mp-woodman/RallyApp/0090_E-Paper_Display/00_Code/00_E_Paper_2_9_Example_VS_Code/MonitorOutput.md

Testprogramm Epaper
[E][esp32-hal-cpu.c:125] removeApbChangeCallback(): not found func=400D660C arg=3FFB1394
