mp-woodman/RallyApp/0120_Hardware/00_ESP_Shield/Partlist.xlsx

Kundenreferenz | Beschreibung | Hersteller-Teilenummer | Hersteller | Distributor | Distributor Teilenummer | Menge | Stückpreis | Gesamtpreis
B1 | BUZZER, 12 MM X 9.5 MM DEEP, M, | CMI-1295IC-0385T | CUI Devices | DigiKey | 2223-CMI-1295IC-0385T-ND | 1 | 1.04 € | 1.04 €
C1,C2 | CAP CER 22PF 50V C0G/NP0 0805 | C0805C220J5GACTU | KEMET | DigiKey | 399-1113-1-ND | 2 | 0.08 € | 0.16 €
C11,C14,C16,C17,C18,C20,C24,C23 | CAP CER 0.1UF 50V X7R 0805 | C0805C104J5RAC7025 | KEMET | DigiKey | 399-C0805C104J5RAC7025CT-ND | 8 | 0.11 € | 0.91 €
C12,C13 | CAP CER 33PF 50V X7R 0805 | 08055C330KAT2A | AVX Corporation | DigiKey | 478-12787-1-ND | 2 | 0.19 € | 0.38 €
C15 | CAP CER 1000PF 50V X7R 0805 | C0805C102K5RAC7210 | KEMET | DigiKey | 399-C0805C102K5RAC7210CT-ND | 1 | 0.10 € | 0.10 €
C19,C22,C25,C21 | CAP CER 10UF 10V X7R 0805 | C0805C106K8RACTU | KEMET | DigiKey | 399-7411-1-ND | 4 | 0.33 € | 1.32 €
C26,C27 | CAP CER 4.7UF 25V X7R 0805 | C0805C475K3RAC7800 | KEMET | DigiKey | 399-C0805C475K3RAC7800CT-ND | 2 | 0.49 € | 0.98 €
C28 | CAP CER 0805 2.2UF 16V X7R 5% | C0805C225J4REC7800 | KEMET | DigiKey | 399-C0805C225J4REC7800CT-ND | 1 | 0.25 € | 0.25 €
C29 | CAP TANT 47UF 20% 10V 0805 | TCSP1A476M8R | Rohm Semiconductor | DigiKey | 511-TCSP1A476M8RCT-ND | 1 | 0.85 € | 0.85 €
C3,C4 | CAP CER 220PF 50V X7R 0805 | C0805C221M5RACTU | KEMET | DigiKey | 399-8039-1-ND | 2 | 0.08 € | 0.16 €
C7,C8 | CAP CER 100PF 50V X7R 0805 | C0805C101J5RAC7800 | KEMET | DigiKey | 399-17420-1-ND | 2 | 0.13 € | 0.26 €
IC1 | IC REG LINEAR 3.3V 1A 8SO | AP7361C-33SP-13 | Diodes Incorporated | DigiKey | AP7361C-33SP-13DICT-ND | 1 | 0.55 € | 0.55 €
IC2 | IC BATT CHG LI-ION 1CELL 6MLP | SC810ULTRT | Semtech Corporation | DigiKey | SC810ULCT-ND | 1 | 1.49 € | 1.49 €
IC3 | IC COMP WINDOW W/REF 6SOT | TPS3700DDCR | Texas Instruments | DigiKey | 296-30395-1-ND | 1 | 1.56 € | 1.56 €
L1, L2 | FERRITE BEAD 100 OHM 0805 1LN | MPZ2012S101AT000 | TDK Corporation | DigiKey | 445-1567-1-ND | 1 | 0.09 € | 0.09 €
L3,L4 | FIXED IND 560NH 450MA 1.1 OHM | 744760256A | Würth Elektronik | DigiKey | 732-3438-1-ND | 2 | 0.36 € | 0.72 €
L3,L4 alternative | FIXED IND 560NH 230MA 1.9 OHM | LQW2BASR56J00L | Murata Electronics | DigiKey | 490-5675-1-ND | 2 | 0.19 € | 0.38 €
L3,L4 alternative | FIXED IND 560NH 150MA 550 MOHM | MLF2012DR56KT000 | TDK Corporation | DigiKey | 445-1044-1-ND | 2 | 0.15 € | 0.30 €
LED1 | LED GREEN CLEAR SMD | LTST-C170KGKT | Lite-On Inc. | DigiKey | 160-1414-1-ND | 1 | 0.29 € | 0.29 €
LED2 | LED RED CLEAR SMD | LTST-C170EKT | Lite-On Inc. | DigiKey | 160-1178-1-ND | 1 | 0.27 € | 0.27 €
PCB | 140mmx85mm two layer PCB | 2.9inch e-Paper Module | JLC PCB | JLCPCB |  | 1 | 3.00 € | 3.00 €
R1 | RES SMD 1K OHM 0.5% 1/5W 0805 | MCU0805MD1001DP500 | Vishay Beyschlag/Draloric/BC Components | DigiKey | MCU0805-1.00K-MDCT-ND | 1 | 0.32 € | 0.32 €
R11 | RES 590K OHM 0.1% 1/8W 0805 | ERA-6AEB5903V | Panasonic Electronic Components | DigiKey | P590KDACT-ND | 1 | 0.26 € | 0.26 €
R12 | RES 47K OHM 0.1% 1/8W 0805 | ERA-6AEB473V | Panasonic Electronic Components | DigiKey | P47KDACT-ND | 1 | 0.26 € | 0.26 €
R13 | RES SMD 64.9K OHM 0.1% 1/4W 0805 | ERJ-PB6B6492V | Panasonic Electronic Components | DigiKey | P20801CT-ND | 1 | 0.27 € | 0.27 €
R14 | RES 50K OHM 0.1% 1/5W 0805 | PTN0805E5002BST1 | Vishay Thin Film | DigiKey | 764-1535-1-ND | 1 | 0.55 € | 0.55 €
R15,R16 | RES SMD 5.1K OHM 1% 0.4W 0805 | RCS08055K10FKEA | Vishay Dale | DigiKey | 541-RCS08055K10FKEACT-ND | 2 | 0.21 € | 0.42 €
R2 | RES 1.69K OHM 0.1% 1/5W 0805 | TNPW08051K69BEEA | Vishay Dale | DigiKey | 541-4562-1-ND | 1 | 0.61 € | 0.61 €
R3,R4 | RES SMD 1.5 OHM 1% 0.4W 0805 | RCS08051R50FKEA | Vishay Dale | DigiKey | 541-10511-1-ND | 2 | 0.21 € | 0.42 €
R7 | RES SMD 10K OHM 0.1% 1/8W 0805 | MCU08050D1002BP500 | Vishay Beyschlag/Draloric/BC Components | DigiKey | MCU0805-10K-DBCT-ND | 1 | 0.48 € | 0.48 €
R8, R10 | RES 130 OHM 0.5% 1/8W 0805 | ERA-6AED131V | Panasonic Electronic Components | DigiKey | P123804CT-ND | 1 | 0.08 € | 0.08 €
R8,R10 alternative | RES SMD 1.3K OHM 1% 0.4W 0805 | RCS08051K30FKEA | Vishay Dale | DigiKey | 541-RCS08051K30FKEACT-ND | 2 | 0.21 € | 0.42 €
R8,R10 alternative | RES SMD 13K OHM 1% 0.4W 0805 | RCS080513K0FKEA | Vishay Dale | DigiKey | 541-RCS080513K0FKEACT-ND | 2 | 0.21 € | 0.42 €
R9 | RES 2.05K OHM 0.1% 1/5W 0805 | TNPW08052K05BEEN | Vishay Dale | DigiKey | 541-1896-1-ND | 1 | 0.72 € | 0.72 €
S1 | SWITCH PUSHBUTTON SPST 1A 30V | GPTS203211B | CW Industries | DigiKey | CW181-ND | 1 | 1.39 € | 1.39 €
U1 | IC RFID RDR/TRAN 13.56MZ 40HVQFN | PN5321A3HN/C106;55 | NXP USA Inc. | DigiKey | 568-8600-ND | 1 | 10.33 € | 10.33 €
U3 alternative | ESP32-WROOM-32E 4MB FLASH | ESP32-DEVKITC-32E | Espressif Systems | DigiKey | 1965-ESP32-DEVKITC-32E-ND | 1 | 8.24 € | 8.24 €
U3 | ESP32-WROOM-32UE 4MB FLASH | ESP32-DEVKITC-32UE | Espressif Systems | DigiKey | 1965-ESP32-DEVKITC-32UE-ND | 1 | 8.24 € | 8.24 €
X1 | CONN RCPT USB2.0 TYPEC 16POS | USB4085-GF-A | GCT | DigiKey | 2073-USB4085-GF-ACT-ND | 1 | 1.10 € | 1.10 €
X3 | CONN HEADER SMD R/A 8POS 2MM | S8B-PH-SM4-TB(LF)(SN) | JST Sales America Inc. | DigiKey | 455-1755-1-ND | 1 | 0.72 € | 0.72 €
X3.1 | CONN HOUSING PH 8POS 2MM WHITE | PHR-8 | JST Sales America Inc. | DigiKey | 455-1189-ND | 1 | 0.13 € | 0.13 €
X3.1 | CONN SOCKET 24-28AWG CRIMP TIN | SPH-002T-P0.5L | JST Sales America Inc. | DigiKey | 455-2148-1-ND | 5 | 0.08 € | 0.40 €
Y1 | CRYSTAL 27.1200MHZ 18PF SMD | 7M-27.120MAAJ-T | TXC CORPORATION | DigiKey | 887-1424-1-ND | 1 | 0.75 € | 0.75 €
 | Lithium Ion Mangan Akku GDIHR18650PC |  | FREI | Reichelt | LIMG GDIHR18650Z | 1 | 7.17 € | 7.17 €
 | Display ePaper, 2,9", schwarz/weiß | li ion 18650 | Waveshare | Reichelt | DEBO EPA 2.9 | 1 | 21.60 € | 21.60 €
 |  |  |  |  |  |  |  | 80.36 €
