mp-woodman/RallyApp/0120_Hardware/00_ESP_Shield/RallyESP_Shield/RallyESP_Shield_V1.brd

## EAGLE design 0120_Hardware/00_ESP_Shield/RallyESP_Shield/RallyESP_Shield_V1.brd (2021-02-15)

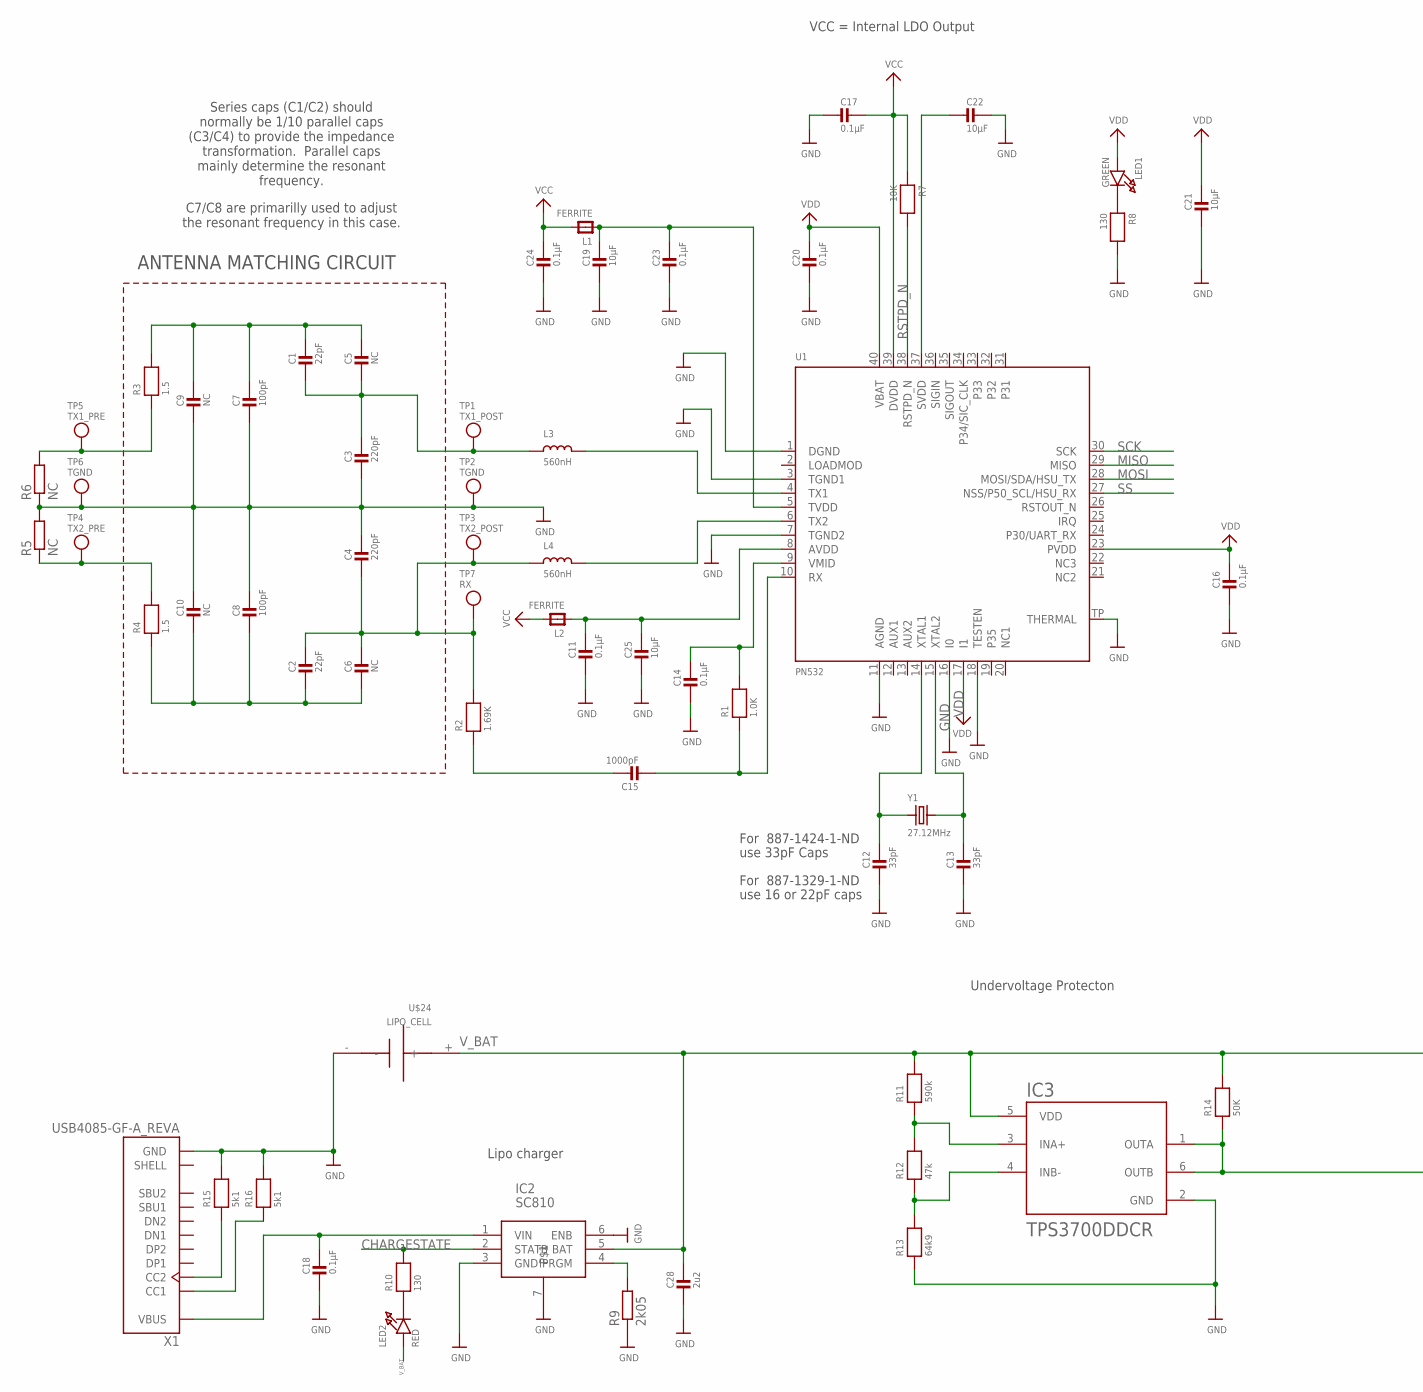
[picture p66: schematic RallyESP_Shield_V1.sch, part in row 1, column 1]

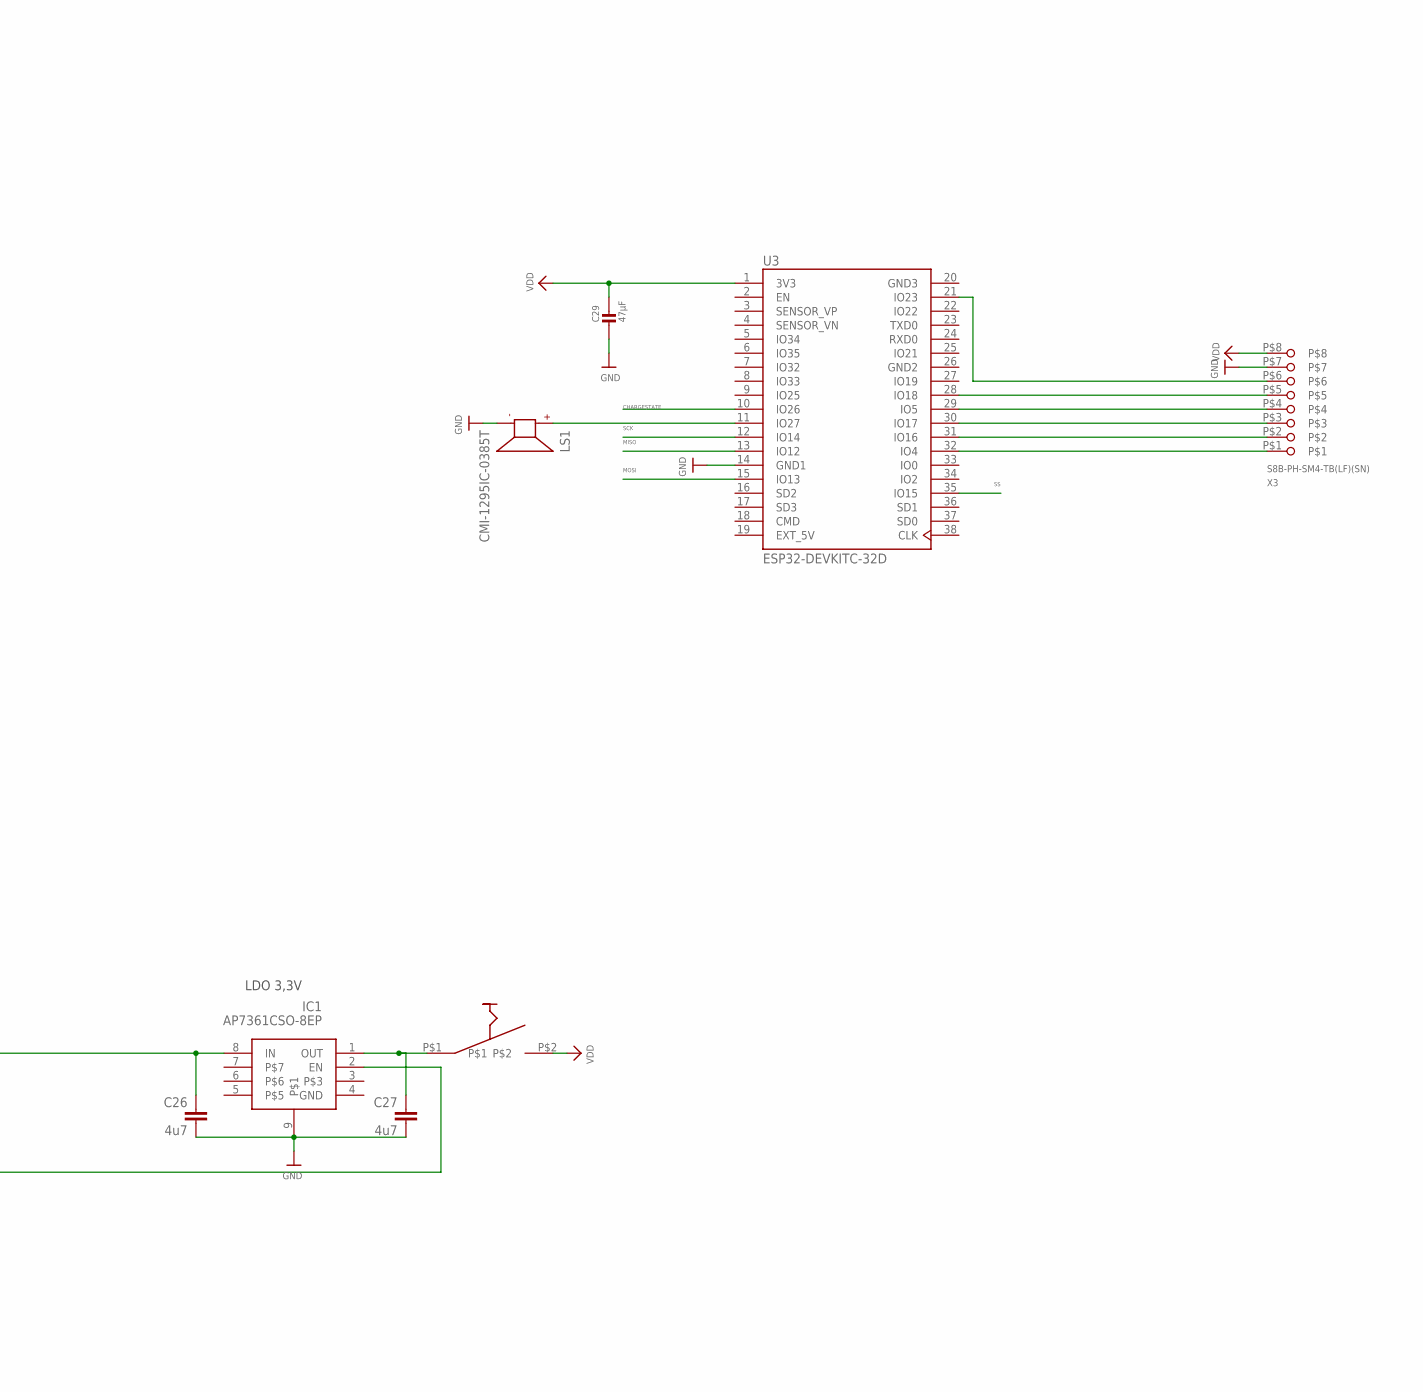
[picture p67: schematic RallyESP_Shield_V1.sch, part in row 1, column 2]

Parts:
C1, C2: 22pF; 0805-NO
C3, C4: 220pF; 0805-NO
C5, C6, C9, C10: NC; 0805-NO
C7, C8: 100pF; 0805-NO
C11, C14, C16, C17, C18, C20, C23, C24: 0.1µF; 0805-NO
C12, C13: 33pF; 0805-NO
C15: 1000pF; 0805-NO
C19, C21, C22, C25: 10µF; 0805-NO
C26, C27: 4u7; C0805
C28: 2u2; 0805-NO
C29: 47µF; 0805-NO
IC1: AP7361CSO-8EP; SOIC127P595X150-9T240X300N
IC2: SC810; MLPD-UT6
IC3: TPS3700DDCR; SOT95P280X110-6N
L1, L2: FERRITE; 0805
L3, L4: 560nH; 0805
LED1: GREEN; CHIPLED_0805_NOOUTLINE
LED2: RED; CHIPLED_0805_NOOUTLINE
LS1: CMI-1295IC-0385T; CUI_CMI-1295IC-0385T
R1: 1.0K; 0805-NO
R2: 1.69K; 0805-NO
R3, R4: 1.5; 0805-NO
R5, R6: NC; R0201
R7: 10K; 0805-NO
R8, R10: 130; 0805-NO
R9: 2k05; R0805
R11: 590k; 0805-NO
R12: 47k; 0805-NO
R13: 64k9; 0805-NO
R14: 50K; 0805-NO
R15, R16: 5k1; 0805-NO
TP1: TX1_POST; TESTPOINT_ROUND_1MM
TP2, TP6: TGND; TESTPOINT_ROUND_1MM
TP3: TX2_POST; TESTPOINT_ROUND_1MM
TP4: TX2_PRE; TESTPOINT_ROUND_1MM
TP5: TX1_PRE; TESTPOINT_ROUND_1MM
TP7: RX; TESTPOINT_ROUND_1MM
U1: PN532; HVQFN40-6X6
U3: ESP32-DEVKITC-32D; MODULE_ESP32-DEVKITC-32D
U$24: LIPO_CELL; LIPO_18X65
U$46: GPTS203211B
X1: USB4085-GF-A_REVA; GCT_USB4085-GF-A_REVA
X3: S8B-PH-SM4-TB(LF)(SN); 8_PIN_SMD_2MM
Y1: 27.12MHz; CRYSTAL_3.2X2.5

Connections:
CHARGESTATE: IC2.2 (STATB), R10.2, U3.10 (IO26)
EXT_5V: U3.19 (EXT_5V)
GND: C3.2, C4.1, C7.2, C8.1, C9.2, C10.1, C11.2, C12.2, C13.2, C14.2, C16.2, C17.2, C18.2, C19.2, C20.2, C21.2, C22.1, C23.2, C24.2, C25.2, C26.2, C27.2, C28.2, C29.2, IC1.9, IC2.3 (GND), IC2.6 (ENB), IC2.7, IC3.2 (GND), LS1.N, R5.2, R6.1, R8.2, R9.1, R13.1, R15.2, R16.2, TP2.P$1, TP6.P$1, U1.1 (DGND), U1.3 (TGND1), U1.7 (TGND2), U1.11 (AGND), U1.16 (I0), U1.18 (TESTEN), U1.TP (THERMAL), U3.14 (GND1), U$24.-, X1.A1 (GND), X1.A12 (GND), X1.B1 (GND), X1.B12 (GND), X3.P$7
GND2: U3.26 (GND2)
GND3: U3.20 (GND3)
MISO: U1.29 (MISO), U3.13 (IO12)
MOSI: U1.28 (MOSI/SDA/HSU_TX), U3.15 (IO13)
unnamed: L3.2, U1.4 (TX1)
unnamed: L4.2, U1.6 (TX2)
unnamed: C1.2, C3.1, C5.2, L3.1, TP1.P$1
unnamed: R3.1, R6.2, TP5.P$1
unnamed: R4.2, R5.1, TP4.P$1
unnamed: LED1.C, R8.1
unnamed: C12.1, U1.14 (XTAL1), Y1.1
unnamed: C13.1, U1.15 (XTAL2), Y1.2
unnamed: C15.1, R2.1
unnamed: C14.1, R1.2, U1.9 (VMID)
unnamed: C15.2, R1.1, U1.10 (RX)
unnamed: C2.1, C4.2, C6.1, L4.1, R2.2, TP3.P$1, TP7.P$1
unnamed: C11.1, C25.1, L2.1, U1.8 (AVDD)
unnamed: C19.1, C23.1, L1.1, U1.5 (TVDD)
unnamed: C22.2, U1.37 (SVDD)
unnamed: LS1.P, U3.11 (IO27)
unnamed: IC3.3 (INA+), R11.1, R12.2
unnamed: IC3.4 (INB-), R12.1, R13.2
unnamed: IC1.2 (EN), IC3.1 (OUTA), IC3.6 (OUTB), R14.1
unnamed: C27.1, IC1.1 (OUT), U$46.P$1
unnamed: R15.1, X1.B5 (CC2)
unnamed: R16.1, X1.A5 (CC1)
unnamed: U3.32 (IO4), X3.P$1
unnamed: U3.31 (IO16), X3.P$2
unnamed: U3.30 (IO17), X3.P$3
unnamed: U3.29 (IO5), X3.P$4
unnamed: U3.28 (IO18), X3.P$5
unnamed: U3.21 (IO23), X3.P$6
unnamed: IC2.4 (IPRGM), R9.2
unnamed: LED2.C, R10.1
unnamed: C18.1, IC2.1 (VIN), X1.A4 (VBUS), X1.A9 (VBUS), X1.B4 (VBUS), X1.B9 (VBUS)
RSTPD_N: R7.2, U1.38 (RSTPD_N)
SCK: U1.30 (SCK), U3.12 (IO14)
SS: U1.27 (NSS/P50_SCL/HSU_RX), U3.35 (IO15)
TX1_ANTENNA: C1.1, C5.1, C7.1, C9.1, R3.2
TX2_ANTENNA: C2.2, C6.2, C8.2, C10.2, R4.1
VCC: C17.1, C24.1, L1.2, L2.2, R7.1, U1.39 (DVDD)
VDD: C16.1, C20.1, C21.1, C29.1, LED1.A, U1.17 (I1), U1.23 (PVDD), U1.40 (VBAT), U3.1 (3V3), U$46.P$2, X3.P$8
V_BAT: C26.1, C28.1, IC1.8 (IN), IC2.5 (BAT), IC3.5 (VDD), LED2.A, R11.2, R14.2, U$24.+

Notes on the sheet:
ANTENNA MATCHING CIRCUIT
For 887-1329-1-ND
use 16 or 22pF caps
For 887-1424-1-ND
use 33pF Caps
VCC = Internal LDO Output
Series caps (C1/C2) should normally be 1/10 parallel caps (C3/C4) to provide the impedance transformation. Parallel caps mainly determine the resonant frequency.
C7/C8 are primarilly used to adjust the resonant frequency in this case.
Undervoltage Protecton
Lipo charger
LDO 3,3V

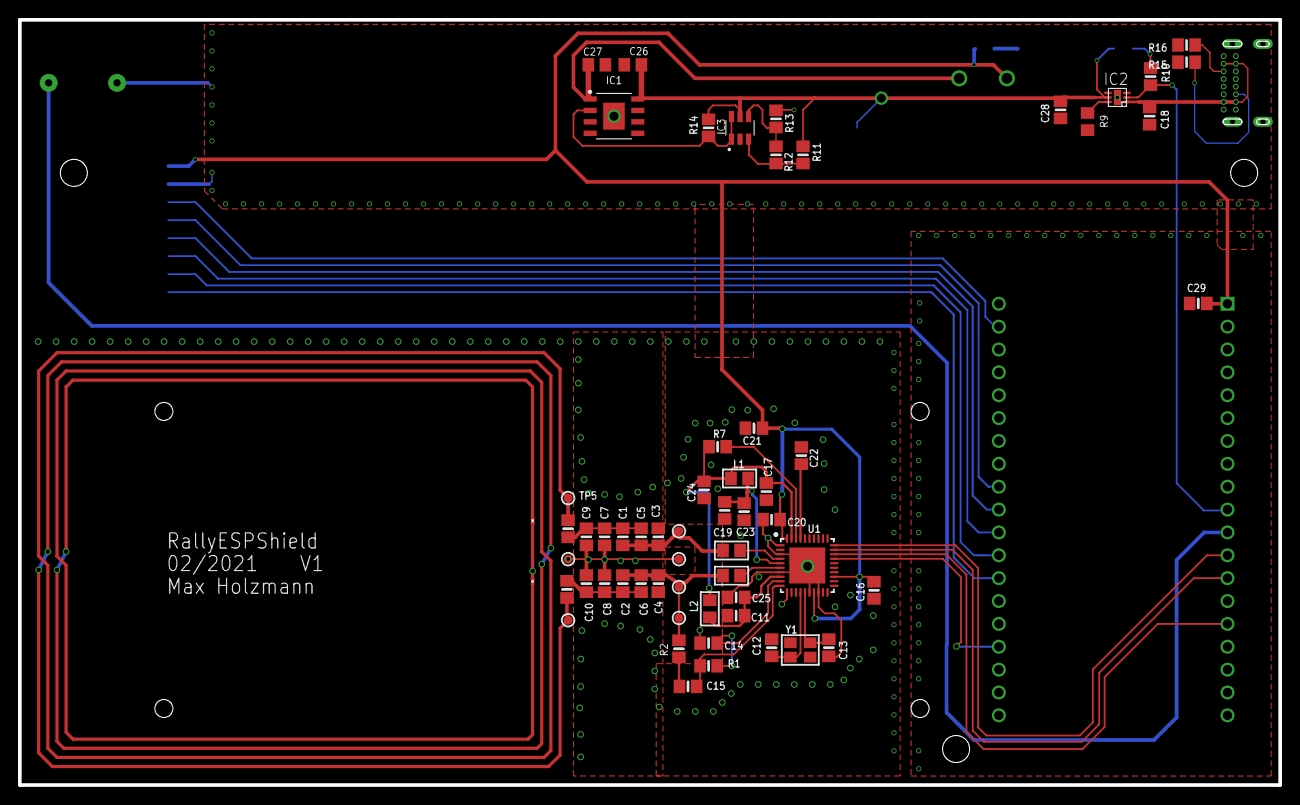
[picture p68: board RallyESP_Shield_V1.brd from above]

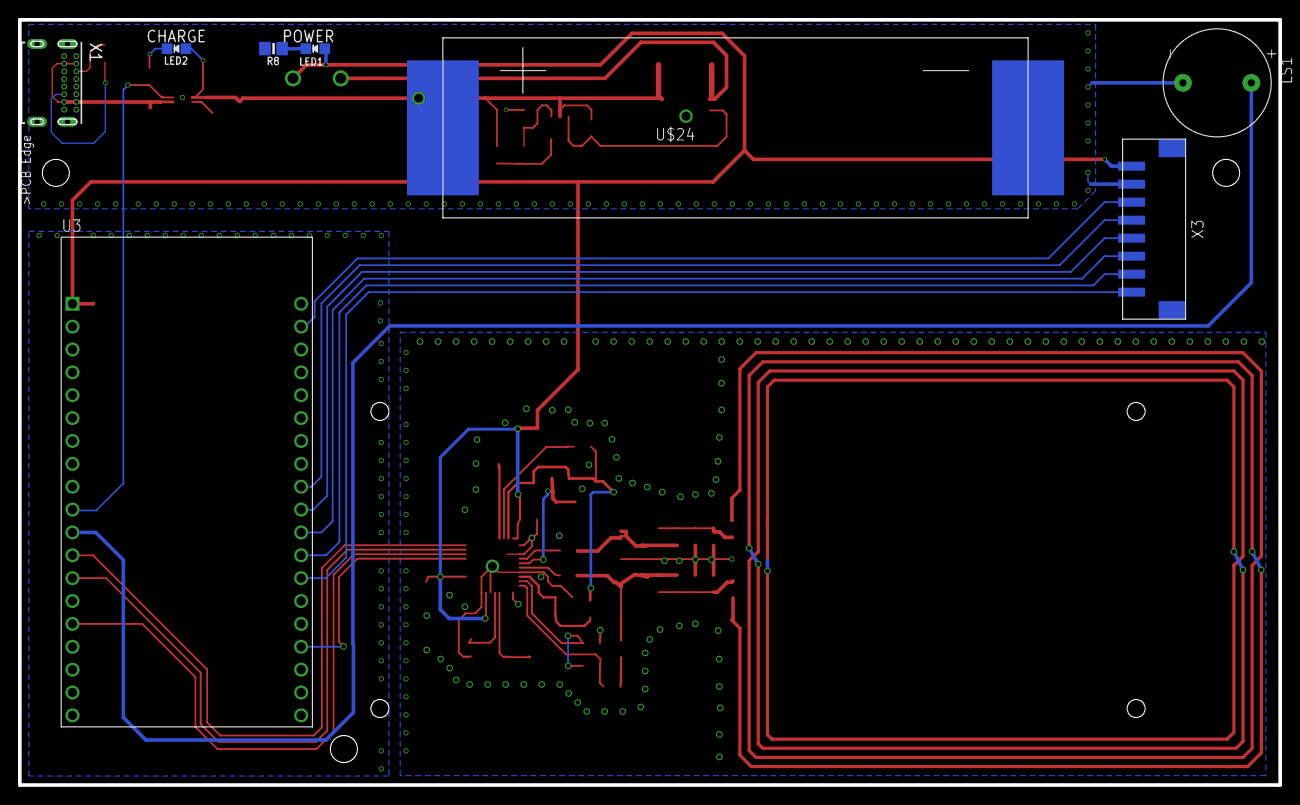
[picture p69: board RallyESP_Shield_V1.brd from below]

Board: 2 copper layers, 140.0 x 85.0 mm, 69 parts (8 on the bottom side), 43 nets.
