mp-woodman/RallyApp/(commit log)

2021-01-18 GITIGNORE und GITATTRIBUTES hinzufügen.
2021-01-18 initial RallyApp Commit
    [BlackBerry_App_Descriptor.xml]
2021-02-15 RallyESPShield PCB added
    [Partlist.xlsx, RallyESP_Shield_V1.brd, RallyESP_Shield_V1.sch]
